wcs3/e30_resto/README.md

# BMW E30 Reproduction Parts

A collection of 3D models, schematics, and guides for reproducing discontinued or hard-to-find BMW E30 parts.
