wcs3/e30_resto/HVAC_Box/README.md

# HVAC Box Restoration

## Plastic Part Reproductions

This folder contains parts found in the HVAC Box of air-conditioning equipped E30s. Some parts may also be applicable to heater-only E30s.

| File | Part Number | OEM Availability | 3D Print Process |
|---|---|---|---|
| [HVAC_RecircFlapInterior_L.stl](HVAC_RecircFlapInterior_L.stl) | 64111372664 | Not Sold Individually | MJF PA12 |
| [HVAC_RecircFlapInterior_R.stl](HVAC_RecircFlapInterior_R.stl) | 64111372663 | Not Sold Individually | MJF PA12 |
| [HVAC_RecircFlapLinkage.stl](HVAC_RecircFlapLinkage.stl) | 64111372593 | No Longer Available | MJF PA11 |
| [HVAC_RecircFlapMotorRodClip.stl](HVAC_RecircFlapMotorRodClip.stl) | 64111372638 | No Longer Available | MJF PA11 |

### Recirculation Flaps Notes
Interior side recirculation flaps are commonly found broken around the ball joint. The provided design is strengthened in that area.

The original design has a nonreusable 6mm *riveted* ball stud. We replace this with an off the shelf *threaded* ball stud used in RC car suspension applications, fixed from behind with an M3 nut.
These threaded ball studs can be found at some RC part stores, or [aliexpress](https://www.aliexpress.com/item/1005008962197158.html).

## Sealing Material

Original foam seals in the HVAC Box of any E30 are almost guaranteed to have completely perished at this point in time. In particular, the foam on the air flaps and the open-cell foam gasket that seals the box to the dash ducting tend to crumble into dust. 

There are no replacements available for the air flap foams, but it is generally recommended to reconstruct those with 3mm or 1/8" adhesive backed neoprene. Neoprene is very durable and has much better environmental resistance than whatever foam was originally used. The replacement foam should be fitted with a 1-2mm overhang to ensure a good seal. The gasket profiles can be cut directly from a foam sheet, or pieced together with 1/2" wide tape.

The ducting gasket is still available from BMW (64111370937), but if that becomes NLA or prohibitively expensive, a possible alternative is to piece it together from strips of open-cell foam tape, approximately 3/4" wide and 1/2" thick.

The seams between the large housing parts of the box are sealed with an oring cord type of gasket. A part exists for the seal between the lower and upper housing (64111372637), but this is NLA. These can be replaced with 2mm oring cord of the appropriate rubber material (EPDM might be a good choice), or a bead of silicone.

## Various Parts

| Part Description | Part Number | OEM Availability | Alternative Sourcing |
|---|---|---|---|
| Vibration Isolator Mount | 64218042132 | Available (Expensive) | Search for vibration mounts with 20mm diameter, 15mm height, and M6x8mm studs (can cut down longer studs if can't find ones with exactly 8mm length) |
| Vibration Isolator Bracket | 64111370637 | Available | Fabricate 35mm x 35mm angle bracket with 7mm x 20mm rounded slots on each flange |
