wcs3/e30_resto/HVAC_Box/HVAC_RecircFlapMotorRodClip.stl

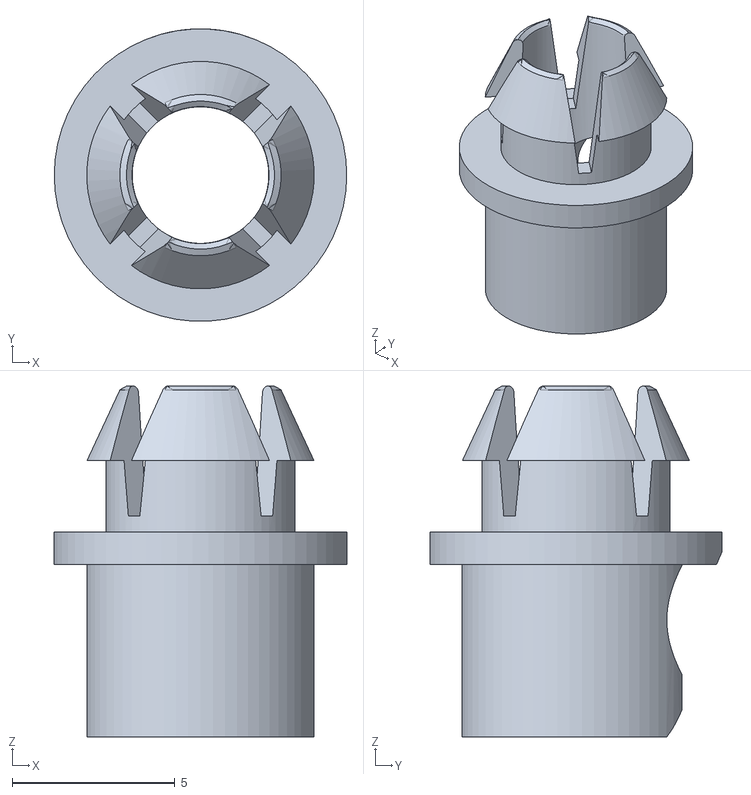
[picture p2: CAD file, 2025-10-10]
HVAC_Box/HVAC_RecircFlapMotorRodClip.stl
9.00 x 8.99 x 10.8
