wcs3/e30_resto/HVAC_Box/HVAC_RecircFlapLinkage.stl

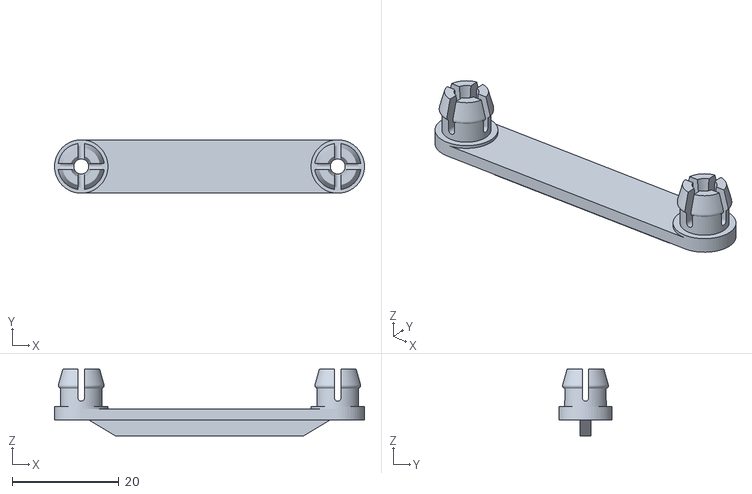
[picture p3: CAD file, 2025-10-06]
HVAC_Box/HVAC_RecircFlapLinkage.stl
58.0 x 10.0 x 12.5
