wcs3/e30_resto/HVAC_Box/HVAC_RecircFlapInterior_L.stl

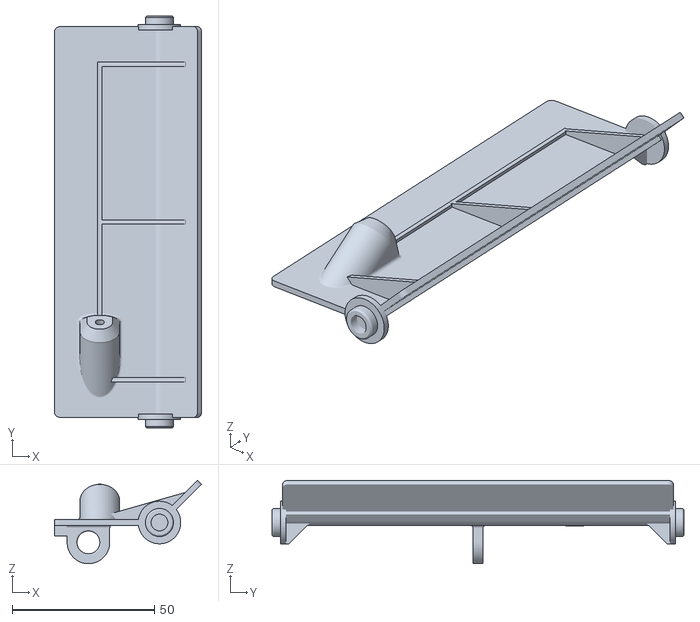
[picture p4: CAD file, 2025-10-06]
HVAC_Box/HVAC_RecircFlapInterior_L.stl
51.8 x 145.0 x 29.3
