wcs3/e30_resto/(list of files, cad)

Other CAD files:
HVAC_Box/HVAC_RecircFlapInterior_R.stl
